Gongrp/Projeto_Embarcados/README.md

Ler o arquivo do relatório para entender.
O código final é o 'Final_bluetooth'
