Gongrp/Projeto_Embarcados/Modelos 3D/chassis_3d_models/Motor_Support.stl

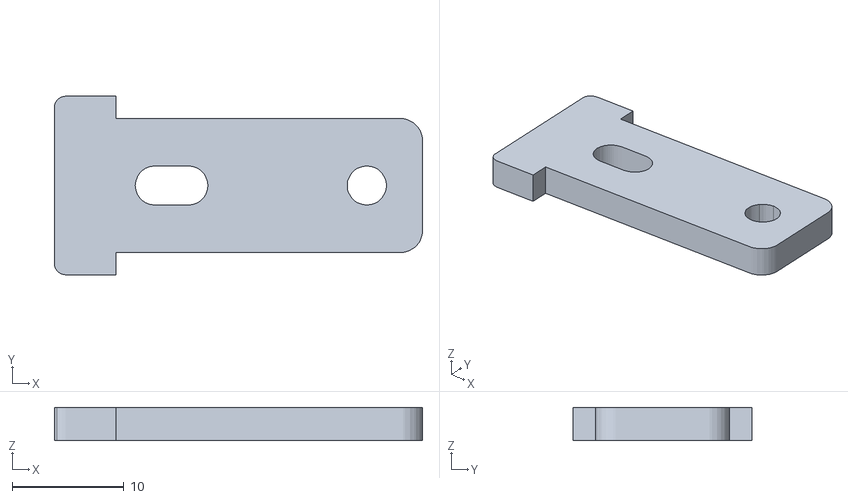
[picture p2: CAD file, 2026-06-08]
Modelos 3D/chassis_3d_models/Motor_Support.stl
33.0 x 16.0 x 3.00
