Gongrp/Projeto_Embarcados/Modelos 3D/ULTRASONIC_HOLDER_NEW_FEB_2020.3mf

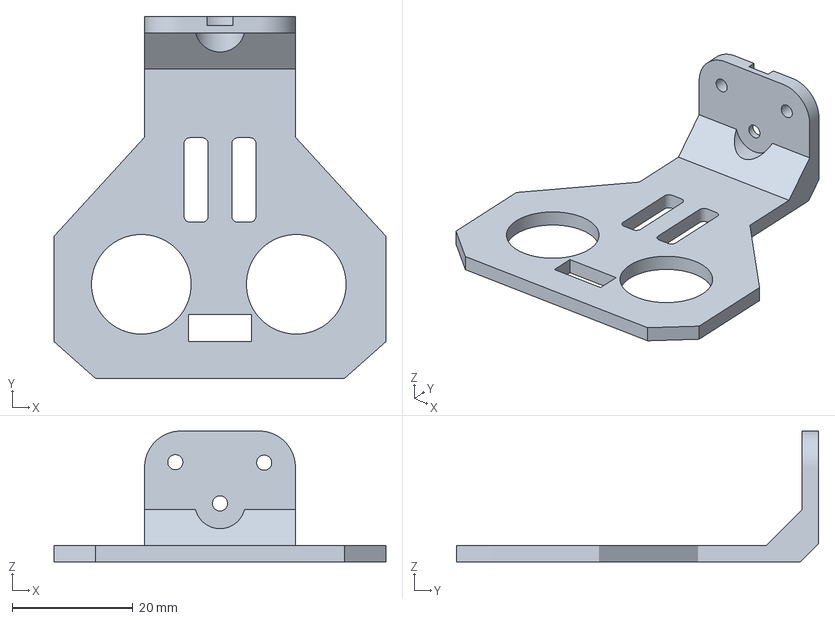
[picture p3: CAD file, 2026-06-17]
Modelos 3D/ULTRASONIC_HOLDER_NEW_FEB_2020.3mf
55.0 x 60.0 x 21.7 mm
