Gongrp/Projeto_Embarcados/Modelos 3D/Chasis.3mf

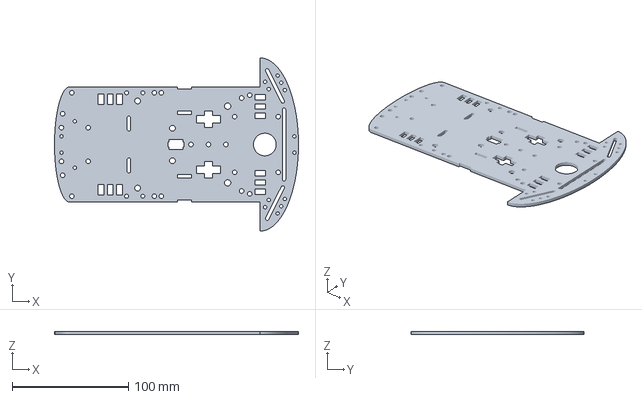
[picture p4: CAD file, 2026-06-12]
Modelos 3D/Chasis.3mf
210.0 x 149.0 x 3.00 mm
