Gongrp/Projeto_Embarcados/Modelos 3D/chassis_3d_models/Motor_part.stl

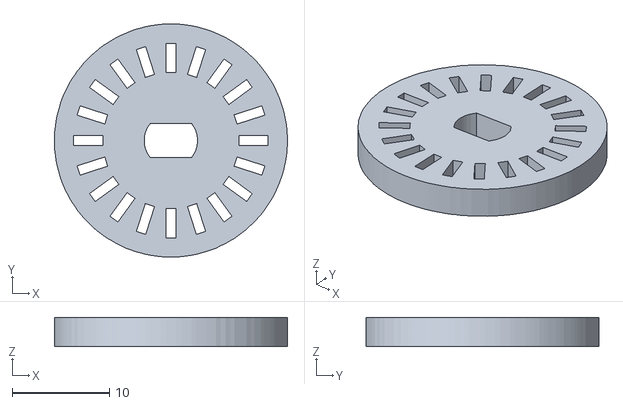
[picture p5: CAD file, 2026-06-08]
Modelos 3D/chassis_3d_models/Motor_part.stl
24.0 x 24.0 x 3.00
