Gongrp/Projeto_Embarcados/(list of files, cad)

Other CAD files:
Modelos 3D/chassis_3d_models/Chasis.stl
Modelos 3D/ULTRASONIC_HOLDER_NEW_FEB_2020.stl
