Gongrp/Projeto_Embarcados/FINAL/Carrinho_v2.asm

;
; ***********************************
; * (Add program task here)         *
; * (Add AVR type and version here) *
; * (C)2021 by Gerhard Schmidt      *
; ***********************************
;
.nolist
.include "m328pdef.inc" ; Define device ATmega328P
.list
;
; **********************************
;        H A R D W A R E
; **********************************
;
; (F2 adds ASCII pin-out for device here)
;
; **********************************
;  P O R T S   A N D   P I N S
; **********************************
;
; (Add symbols for all ports and port pins with ".equ" here)
; (e.g. .equ pDirD = DDRB ; Define a direction port
;  or
;  .equ bMyPinO = PORTB0 ; Define an output pin)
;
; **********************************
;   A D J U S T A B L E   C O N S T
; **********************************
;
; (Add all user adjustable constants here, e.g.)
; .equ clock=1000000 ; Define the clock frequency
;
; **********************************
;  F I X  &  D E R I V.  C O N S T
; **********************************
;
; (Add symbols for fixed and derived constants here)
;
; **********************************
;       R E G I S T E R S
; **********************************
;
; free: R0 to R14
.def rSreg = R15 ; Save/Restore status port
.def rmp = R16 ; Define multipurpose register
; free: R17 to R29
; free: R31:R30 = Z
;
; **********************************
;           S R A M
; **********************************
;
.dseg
.org SRAM_START
; (Add labels for SRAM locations here, e.g.
; sLabel1:
;   .byte 16 ; Reserve 16 bytes)
;
; **********************************
;         C O D E
; **********************************
;
.cseg
.org 000000
;
; **********************************
; R E S E T  &  I N T - V E C T O R S
; **********************************
	rjmp Main ; Reset vector
	nop
	reti ; INT0
	nop
	reti ; INT1
	nop
	reti ; PCI0
	nop
	reti ; PCI1
	nop
	reti ; PCI2
	nop
	reti ; WDT
	nop
	reti ; OC2A
	nop
	reti ; OC2B
	nop
	reti ; OVF2
	nop
	reti ; ICP1
	nop
	reti ; OC1A
	nop
	reti ; OC1B
	nop
	reti ; OVF1
	nop
	reti ; OC0A
	nop
	reti ; OC0B
	nop
	reti ; OVF0
	nop
	reti ; SPI
	nop
	reti ; URXC
	nop
	reti ; UDRE
	nop
	reti ; UTXC
	nop
	reti ; ADCC
	nop
	reti ; ERDY
	nop
	reti ; ACI
	nop
	reti ; TWI
	nop
	reti ; SPMR
	nop
;
; **********************************
;  I N T - S E R V I C E   R O U T .
; **********************************
;
; (Add all interrupt service routines here)
;
; **********************************
;  M A I N   P R O G R A M   I N I T
; **********************************
;
Main:
.ifdef SPH ; if SPH is defined
  ldi rmp,High(RAMEND)
  out SPH,rmp ; Init MSB stack pointer
  .endif
	ldi rmp,Low(RAMEND)
	out SPL,rmp ; Init LSB stack pointer
; ...
	sei ; Enable interrupts
;
; **********************************
;    P R O G R A M   L O O P
; **********************************
;
Loop:
	rjmp loop
;
; End of source code
;
; (Add Copyright information here, e.g.
; .db "(C)2021 by Gerhard Schmidt  " ; Source code readable
; .db "C(2)20 1ybG reahdrS hcimtd  " ; Machine code format
;
