Gongrp/Projeto_Embarcados/(commit log)

2026-06-08 Modelos 3D
    [Chasis.stl, Motor_Support.stl, Motor_part.stl, ULTRASONIC_HOLDER_NEW_FEB_2020.stl]
2026-06-12 Código teste motores
    [Chasis.3mf]
2026-06-17 Código Bluetooth atualizado
    Para ser testado com o módulo de bluetooth e aplicativo BLE Controller. Após isso, falta inserir as instruções específicas de cada subrotina.
    [ULTRASONIC_HOLDER_NEW_FEB_2020.3mf]
2026-06-17 Add HC-SR04 obstacle detection module
    Essa é a versão que o cloude corrigiu não consegui testar em casa
2026-06-20 Add ultrasonic sensor code for autonomous cart
2026-06-22 Correção código bluetooth
    [Chasis.3mf, Chasis.stl, Motor_Support.stl, Motor_part.stl, ULTRASONIC_HOLDER_NEW_FEB_2020.3mf, ULTRASONIC_HOLDER_NEW_FEB_2020.stl]
2026-06-23 Código motores
2026-06-23 Código do sensor ultrassônico (funciona só a distâncias muito curtas)
2026-06-25 Add assembly code for HC-SR04 ultrasonic sensor (aaaaaaaaaaaaaaaaaaaaaaaaaaaaaaaaaaaaaaaaaaaaaaaaaaaaaaaaa)
    This file contains the assembly code for an autonomous cart project using the HC-SR04 ultrasonic sensor with Timer2 configured for a prescaler of 1024. It includes setup, main loop, and functions for triggering the sensor, measuring distance, and controlling an LED based on distance thresholds.
2026-06-26 morra código de mmerda
    Updated project description and corrected comments for clarity. Improved timer handling and variable declarations.
    [Ultrakill_your.asm]
2026-06-30 Versão corrigida pós-teste do código final
    Revisar o que pode ter causado comportamento errático (paradas súbitas e sensor não acionando quando deveria)
    [Final_bluetooth.asm]
